wwkkww1983/DC_Electronic_Load/思路一：以实际电流作为y,反馈ADC2作为x，暂时作废/Minisys_new_msp430f5529_beta1.0/Readme.txt

编辑于2020.7.21晚22：46
CC_Mode已经完全OK，还没有增加电流显示函数
实际电流值CC_value_fact还没有设置成全局变量
