wwkkww1983/DC_Electronic_Load/思路一：以实际电流作为y,反馈ADC2作为x，暂时作废/Minisys_new_msp430f5529_beta2.0/Readme.txt

beta2.0编辑于2020.7.22下午15：49
1、CC_Mode已经完全OK，增加了电流显示函数
2、根据季老师的指导，按键KEY3按下瞬间，CC_voltage=CC_value，将用户电流值先直接传送给数转模拟输出DACOUT()，之后再根据ADC2的反馈进行电流值的调整，经过测试大约需要5S左右。
3、界面1还是4个模式CC_mode,CV_Mode,CR_Mode,Developer Mode
4、实际电流值就是实时显示，并没有取平均值，之间测试取平均值会有问题，始终是负数。
5、目前存在的现象是：按下参数调节按键KEY1和KEY2，界面被Hold（保持），只有按下参数确定按键KEY3后监控界面才会有变化，个人判断应该是触动了某些标志变量
