wwkkww1983/DC_Electronic_Load/思路二：以DAC8571实际输出输出DA作为y,实际电流I作为x/Minisys_new_msp430f5529_beta5.0/Readme.txt

1、在Beta4.0恒流模式的基础上增加了恒阻模式CR，到此直流电子负载的基本要求达到满足，发挥部分也完成了2个
编辑于2020/7/28 江瀚林
