wwkkww1983/DC_Electronic_Load/(list of files, cad)

Other CAD files:
思路一：以实际电流作为y,反馈ADC2作为x，暂时作废/Minisys_new_msp430f5529_beta1.0/Debug/src/main.obj
思路一：以实际电流作为y,反馈ADC2作为x，暂时作废/Minisys_new_msp430f5529_beta2.0/Debug/src/main.obj
思路一：以实际电流作为y,反馈ADC2作为x，暂时作废/Minisys_new_msp430f5529_beta3.0/Debug/src/main.obj
思路二：以DAC8571实际输出输出DA作为y,实际电流I作为x/Minisys_new_msp430f5529_beta5.0/Debug/src/main.obj
思路二：以DAC8571实际输出输出DA作为y,实际电流I作为x/Minisys_new_msp430f5529_beta4.0/Debug/src/main.obj
思路一：以实际电流作为y,反馈ADC2作为x，暂时作废/Minisys_new_msp430f5529_beta1.0/Debug/src/device/usci_a0_spi.obj
思路一：以实际电流作为y,反馈ADC2作为x，暂时作废/Minisys_new_msp430f5529_beta1.0/Debug/src/driver/ssd1351.obj
思路一：以实际电流作为y,反馈ADC2作为x，暂时作废/Minisys_new_msp430f5529_beta1.0/Debug/src/system/lut.obj
思路一：以实际电流作为y,反馈ADC2作为x，暂时作废/Minisys_new_msp430f5529_beta1.0/Debug/src/user/display_value.obj
思路一：以实际电流作为y,反馈ADC2作为x，暂时作废/Minisys_new_msp430f5529_beta2.0/Debug/src/device/usci_b0_spi.obj
思路一：以实际电流作为y,反馈ADC2作为x，暂时作废/Minisys_new_msp430f5529_beta2.0/Debug/src/driver/dac8571.obj
思路一：以实际电流作为y,反馈ADC2作为x，暂时作废/Minisys_new_msp430f5529_beta2.0/Debug/src/system/user.obj
思路一：以实际电流作为y,反馈ADC2作为x，暂时作废/Minisys_new_msp430f5529_beta2.0/Debug/src/user/display_value.obj
思路一：以实际电流作为y,反馈ADC2作为x，暂时作废/Minisys_new_msp430f5529_beta3.0/Debug/src/device/soft_spi.obj
思路一：以实际电流作为y,反馈ADC2作为x，暂时作废/Minisys_new_msp430f5529_beta3.0/Debug/src/driver/led.obj
思路一：以实际电流作为y,反馈ADC2作为x，暂时作废/Minisys_new_msp430f5529_beta3.0/Debug/src/system/fonts.obj
思路一：以实际电流作为y,反馈ADC2作为x，暂时作废/Minisys_new_msp430f5529_beta3.0/Debug/src/user/display_value.obj
思路二：以DAC8571实际输出输出DA作为y,实际电流I作为x/Minisys_new_msp430f5529_beta4.0/Debug/src/device/wdt.obj
思路二：以DAC8571实际输出输出DA作为y,实际电流I作为x/Minisys_new_msp430f5529_beta4.0/Debug/src/driver/led.obj
思路二：以DAC8571实际输出输出DA作为y,实际电流I作为x/Minisys_new_msp430f5529_beta4.0/Debug/src/system/user.obj
思路二：以DAC8571实际输出输出DA作为y,实际电流I作为x/Minisys_new_msp430f5529_beta4.0/Debug/src/user/display_value.obj
思路二：以DAC8571实际输出输出DA作为y,实际电流I作为x/Minisys_new_msp430f5529_beta4.0/Debug/src/vector.obj
思路二：以DAC8571实际输出输出DA作为y,实际电流I作为x/Minisys_new_msp430f5529_beta5.0/Debug/src/device/usci_b0_i2c.obj
思路二：以DAC8571实际输出输出DA作为y,实际电流I作为x/Minisys_new_msp430f5529_beta5.0/Debug/src/driver/led.obj
思路二：以DAC8571实际输出输出DA作为y,实际电流I作为x/Minisys_new_msp430f5529_beta5.0/Debug/src/system/user.obj
思路二：以DAC8571实际输出输出DA作为y,实际电流I作为x/Minisys_new_msp430f5529_beta5.0/Debug/src/user/display_value.obj
思路一：以实际电流作为y,反馈ADC2作为x，暂时作废/Minisys_new_msp430f5529_beta1.0/Debug/src/device/usci_b0_spi.obj
思路一：以实际电流作为y,反馈ADC2作为x，暂时作废/Minisys_new_msp430f5529_beta1.0/Debug/src/driver/key.obj
思路一：以实际电流作为y,反馈ADC2作为x，暂时作废/Minisys_new_msp430f5529_beta1.0/Debug/src/system/init.obj
思路一：以实际电流作为y,反馈ADC2作为x，暂时作废/Minisys_new_msp430f5529_beta1.0/Debug/src/vector.obj
思路一：以实际电流作为y,反馈ADC2作为x，暂时作废/Minisys_new_msp430f5529_beta2.0/Debug/src/device/usci_a0_spi.obj
思路一：以实际电流作为y,反馈ADC2作为x，暂时作废/Minisys_new_msp430f5529_beta2.0/Debug/src/driver/ads1118.obj
思路一：以实际电流作为y,反馈ADC2作为x，暂时作废/Minisys_new_msp430f5529_beta2.0/Debug/src/system/lut.obj
思路一：以实际电流作为y,反馈ADC2作为x，暂时作废/Minisys_new_msp430f5529_beta2.0/Debug/src/vector.obj
思路一：以实际电流作为y,反馈ADC2作为x，暂时作废/Minisys_new_msp430f5529_beta3.0/Debug/src/device/usci_b0_i2c.obj
思路一：以实际电流作为y,反馈ADC2作为x，暂时作废/Minisys_new_msp430f5529_beta3.0/Debug/src/driver/key.obj
思路一：以实际电流作为y,反馈ADC2作为x，暂时作废/Minisys_new_msp430f5529_beta3.0/Debug/src/system/user.obj
思路一：以实际电流作为y,反馈ADC2作为x，暂时作废/Minisys_new_msp430f5529_beta3.0/Debug/src/vector.obj
思路二：以DAC8571实际输出输出DA作为y,实际电流I作为x/Minisys_new_msp430f5529_beta4.0/Debug/src/device/ucs.obj
思路二：以DAC8571实际输出输出DA作为y,实际电流I作为x/Minisys_new_msp430f5529_beta4.0/Debug/src/driver/key.obj
思路二：以DAC8571实际输出输出DA作为y,实际电流I作为x/Minisys_new_msp430f5529_beta4.0/Debug/src/system/init.obj
思路二：以DAC8571实际输出输出DA作为y,实际电流I作为x/Minisys_new_msp430f5529_beta5.0/Debug/src/device/usci_b1_spi.obj
思路二：以DAC8571实际输出输出DA作为y,实际电流I作为x/Minisys_new_msp430f5529_beta5.0/Debug/src/driver/ssd1351.obj
思路二：以DAC8571实际输出输出DA作为y,实际电流I作为x/Minisys_new_msp430f5529_beta5.0/Debug/src/system/lut.obj
思路二：以DAC8571实际输出输出DA作为y,实际电流I作为x/Minisys_new_msp430f5529_beta5.0/Debug/src/vector.obj
思路一：以实际电流作为y,反馈ADC2作为x，暂时作废/Minisys_new_msp430f5529_beta1.0/Debug/src/device/usci_a1_spi.obj
思路一：以实际电流作为y,反馈ADC2作为x，暂时作废/Minisys_new_msp430f5529_beta1.0/Debug/src/driver/dac8571.obj
思路一：以实际电流作为y,反馈ADC2作为x，暂时作废/Minisys_new_msp430f5529_beta1.0/Debug/src/system/fonts.obj
思路一：以实际电流作为y,反馈ADC2作为x，暂时作废/Minisys_new_msp430f5529_beta2.0/Debug/src/device/soft_i2c.obj
思路一：以实际电流作为y,反馈ADC2作为x，暂时作废/Minisys_new_msp430f5529_beta2.0/Debug/src/driver/key.obj
思路一：以实际电流作为y,反馈ADC2作为x，暂时作废/Minisys_new_msp430f5529_beta2.0/Debug/src/system/fonts.obj
思路一：以实际电流作为y,反馈ADC2作为x，暂时作废/Minisys_new_msp430f5529_beta3.0/Debug/src/device/usci_b0_spi.obj
思路一：以实际电流作为y,反馈ADC2作为x，暂时作废/Minisys_new_msp430f5529_beta3.0/Debug/src/driver/dac8571.obj
思路一：以实际电流作为y,反馈ADC2作为x，暂时作废/Minisys_new_msp430f5529_beta3.0/Debug/src/system/init.obj
思路二：以DAC8571实际输出输出DA作为y,实际电流I作为x/Minisys_new_msp430f5529_beta4.0/Debug/src/device/soft_i2c.obj
思路二：以DAC8571实际输出输出DA作为y,实际电流I作为x/Minisys_new_msp430f5529_beta4.0/Debug/src/driver/ssd1351.obj
思路二：以DAC8571实际输出输出DA作为y,实际电流I作为x/Minisys_new_msp430f5529_beta4.0/Debug/src/system/lut.obj
思路二：以DAC8571实际输出输出DA作为y,实际电流I作为x/Minisys_new_msp430f5529_beta5.0/Debug/src/device/usci_b1_i2c.obj
思路二：以DAC8571实际输出输出DA作为y,实际电流I作为x/Minisys_new_msp430f5529_beta5.0/Debug/src/driver/ads1118.obj
思路二：以DAC8571实际输出输出DA作为y,实际电流I作为x/Minisys_new_msp430f5529_beta5.0/Debug/src/system/init.obj
思路一：以实际电流作为y,反馈ADC2作为x，暂时作废/Minisys_new_msp430f5529_beta1.0/Debug/src/device/usci_b0_i2c.obj
思路一：以实际电流作为y,反馈ADC2作为x，暂时作废/Minisys_new_msp430f5529_beta1.0/Debug/src/driver/ads1118.obj
思路一：以实际电流作为y,反馈ADC2作为x，暂时作废/Minisys_new_msp430f5529_beta1.0/Debug/src/system/user.obj
思路一：以实际电流作为y,反馈ADC2作为x，暂时作废/Minisys_new_msp430f5529_beta2.0/Debug/src/device/usci_a1_spi.obj
思路一：以实际电流作为y,反馈ADC2作为x，暂时作废/Minisys_new_msp430f5529_beta2.0/Debug/src/driver/led.obj
思路一：以实际电流作为y,反馈ADC2作为x，暂时作废/Minisys_new_msp430f5529_beta2.0/Debug/src/system/init.obj
思路一：以实际电流作为y,反馈ADC2作为x，暂时作废/Minisys_new_msp430f5529_beta3.0/Debug/src/device/ucs.obj
思路一：以实际电流作为y,反馈ADC2作为x，暂时作废/Minisys_new_msp430f5529_beta3.0/Debug/src/driver/ads1118.obj
思路一：以实际电流作为y,反馈ADC2作为x，暂时作废/Minisys_new_msp430f5529_beta3.0/Debug/src/system/lut.obj
思路二：以DAC8571实际输出输出DA作为y,实际电流I作为x/Minisys_new_msp430f5529_beta4.0/Debug/src/device/usci_b0_spi.obj
思路二：以DAC8571实际输出输出DA作为y,实际电流I作为x/Minisys_new_msp430f5529_beta4.0/Debug/src/driver/ads1118.obj
思路二：以DAC8571实际输出输出DA作为y,实际电流I作为x/Minisys_new_msp430f5529_beta4.0/Debug/src/system/fonts.obj
思路二：以DAC8571实际输出输出DA作为y,实际电流I作为x/Minisys_new_msp430f5529_beta5.0/Debug/src/device/usci_a1_spi.obj
思路二：以DAC8571实际输出输出DA作为y,实际电流I作为x/Minisys_new_msp430f5529_beta5.0/Debug/src/driver/dac8571.obj
思路二：以DAC8571实际输出输出DA作为y,实际电流I作为x/Minisys_new_msp430f5529_beta5.0/Debug/src/system/fonts.obj
思路一：以实际电流作为y,反馈ADC2作为x，暂时作废/Minisys_new_msp430f5529_beta1.0/Debug/src/device/ucs.obj
思路一：以实际电流作为y,反馈ADC2作为x，暂时作废/Minisys_new_msp430f5529_beta1.0/Debug/src/driver/led.obj
思路一：以实际电流作为y,反馈ADC2作为x，暂时作废/Minisys_new_msp430f5529_beta2.0/Debug/src/device/usci_b0_i2c.obj
思路一：以实际电流作为y,反馈ADC2作为x，暂时作废/Minisys_new_msp430f5529_beta2.0/Debug/src/driver/ssd1351.obj
思路一：以实际电流作为y,反馈ADC2作为x，暂时作废/Minisys_new_msp430f5529_beta3.0/Debug/src/device/usci_a0_spi.obj
思路一：以实际电流作为y,反馈ADC2作为x，暂时作废/Minisys_new_msp430f5529_beta3.0/Debug/src/driver/ssd1351.obj
思路二：以DAC8571实际输出输出DA作为y,实际电流I作为x/Minisys_new_msp430f5529_beta4.0/Debug/src/device/usci_b1_spi.obj
思路二：以DAC8571实际输出输出DA作为y,实际电流I作为x/Minisys_new_msp430f5529_beta4.0/Debug/src/driver/dac8571.obj
思路二：以DAC8571实际输出输出DA作为y,实际电流I作为x/Minisys_new_msp430f5529_beta5.0/Debug/src/device/ucs.obj
思路二：以DAC8571实际输出输出DA作为y,实际电流I作为x/Minisys_new_msp430f5529_beta5.0/Debug/src/driver/key.obj
思路一：以实际电流作为y,反馈ADC2作为x，暂时作废/Minisys_new_msp430f5529_beta1.0/Debug/src/device/soft_i2c.obj
思路一：以实际电流作为y,反馈ADC2作为x，暂时作废/Minisys_new_msp430f5529_beta2.0/Debug/src/device/usci_b1_i2c.obj
思路一：以实际电流作为y,反馈ADC2作为x，暂时作废/Minisys_new_msp430f5529_beta3.0/Debug/src/device/wdt.obj
思路二：以DAC8571实际输出输出DA作为y,实际电流I作为x/Minisys_new_msp430f5529_beta4.0/Debug/src/device/usci_a1_spi.obj
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
