wwkkww1983/DC_Electronic_Load/思路一：以实际电流作为y,反馈ADC2作为x，暂时作废/Minisys_new_msp430f5529_beta1.0/src/driver/ads1118.c

/*

 * ads1118.c
 *
 *  Created on: 2018-05-17 11:23
 *      Author: Jack Chen <redchenjs@live.com>
 *  Fixed on :  2018-05-25 11:14
 *      Author: art-j <jjw903427521@gmail.com>
*/

/*

#include <stdint.h>
#include <string.h>

#include <msp430.h>

#include <inc/driver/ads1118.h>
#include <inc/device/usci_b1_spi.h>

#define SS_NONE     0b0
#define SS_START    0b1

#define MUX_D0_1    0b000
#define MUX_D0_3    0b001
#define MUX_D1_3    0b010
#define MUX_D2_3    0b011
#define MUX_S0      0b100
#define MUX_S1      0b101
#define MUX_S2      0b110
#define MUX_S3      0b111

#define PGA_6_144   0b000
#define PGA_4_096   0b001
#define PGA_2_048   0b010
#define PGA_1_024   0b011
#define PGA_0_512   0b100
#define PGA_0_256   0b101

#define MODE_CONTINOUS  0b0
#define MODE_SINGLE     0b1

#define DR_8_SPS    0b000
#define DR_16_SPS   0b001
#define DR_32_SPS   0b010
#define DR_64_SPS   0b011
#define DR_128_SPS  0b100
#define DR_250_SPS  0b101
#define DR_475_SPS  0b110
#define DR_860_SPS  0b111

#define TS_MODE_ADC     0b0
#define TS_MODE_TEMP    0b1

#define PULL_UP_EN_OFF  0b0
#define PULL_UP_EN_ON   0b1

#define NOP_DATA_INVALID    0b00
#define NOP_DATA_VALID      0b01

#define RESERVED_BIT    0b1

static ads1118_t ads1118_dev;
ads1118_t *ads1118 = &ads1118_dev;

static int16_t ads1118_transmit(uint8_t *data)
{
    unsigned char tx_buff[4] = {0};
    unsigned char rx_buff[4] = {0};

    tx_buff[0] = data[1];
    tx_buff[1] = data[0];
    tx_buff[2] = 0;
    tx_buff[3] = 0;

    P4OUT &=~BIT0;
    usci_b1_spi_transmit_frame(tx_buff, rx_buff, 4);
    P4OUT |= BIT0;

    return rx_buff[0] << 8 | rx_buff[1];
}

void ads1118_set_channel(uint8_t channel)
{
    switch (channel) {
    case 0:
        ads1118->bits.mux = MUX_S0;
        break;
    case 1:
        ads1118->bits.mux = MUX_S1;
        break;
    case 2:
        ads1118->bits.mux = MUX_S2;
        break;
    case 3:
        ads1118->bits.mux = MUX_S3;
        break;
    default:
        return;
    }

    ads1118_transmit((uint8_t *)ads1118);
}

int16_t ads1118_convert(void)
{
    return ads1118_transmit((uint8_t *)"\x00\x00");
}

void ads1118_init(void)
{
    P4DIR |= BIT0;
    P4OUT |= BIT0;

    memset(&ads1118_dev, 0, sizeof(ads1118_dev));

    ads1118->bits.ss = SS_NONE;
    ads1118->bits.mux = MUX_S0;
    ads1118->bits.pga = PGA_2_048;
    ads1118->bits.mode = MODE_CONTINOUS;
    ads1118->bits.dr = DR_860_SPS;
    ads1118->bits.ts_mode = TS_MODE_ADC;
    ads1118->bits.pull_up_en = PULL_UP_EN_ON;
    ads1118->bits.nop = NOP_DATA_VALID;
    ads1118->bits.reserved = RESERVED_BIT;

    ads1118_transmit((uint8_t *)ads1118);
}
*/

//////////////////////////////////////////////////////
//AIN输入端口（正-负）                              //
//  0:AIN0-AIN1 1:AIN0-AIN3 2:AIN1-AIN3 3:AIN2-AIN3 //
//  4:AIN0-GND  5:AIN1-GND  6:AIN2-GND  7:AIN3-GND  //
//量程                                                //
//  0:±6.144V 1:±4.096V 2:±2.048V 3:±1.024V     //
//  4:±0.512V 5:±0.256V 6:±0.256V 7:±0.256V     //
//////////////////////////////////////////////////////
#include "msp430f5529.h"
#include <inc/driver/ssd1351.h>
#include <inc/system/fonts.h>
#include <stdio.h>
#include <math.h>
#include <src/user/display_value.h>
#include <inc/system/user.h>
#define SCLK_H P4OUT |= BIT3
#define SCLK_L P4OUT &= ~BIT3
#define CS_H P4OUT |= BIT0
#define CS_L P4OUT &= ~BIT0
#define DataIN_H P4OUT |= BIT1
#define DataIN_L P4OUT &= ~BIT1

#define uint unsigned int
#define uchar unsigned char
float a0 = 0, a1 = 0, a2 = 0;

void ADS1118_Init(void)
{
    P4DIR |= BIT0;  //CS
    P4DIR |= BIT3;  //SCK
    P4DIR |= BIT1;  //输出，单片机写数据DIN
    P4DIR &= ~BIT2; //输入，单片机读数据OUT
}

//****************************************************************
//* 函数名称：WriteSPI
//* 功能描述：开始SPI写数据
//* 入口参数：config
//* 返回参数：void
//****************************************************************
void WriteSPI(uint config)
{
    uint i = 0;
    CS_L;
    SCLK_L;
    //delay_us(200);
    for (i = 0; i < 16; i++)
    {
        SCLK_H;
        //delay_us(200);
        if (config & 0x8000)
        {
            DataIN_H;
        }
        else
        {
            DataIN_L;
        }
        config <<= 1;
        SCLK_L;
        //delay_us(200);
    }
    CS_H;
}

//****************************************************************
//* 函数名称：ADS_ReadSPI读
//* 功能描述：开始SPI读数据
//* 入口参数：void
//* 返回参数：unsigned int
//****************************************************************
uint ADS_Read()
{
    uint i = 0;
    uint adc;
    CS_L;
    adc = 0x0000;

    while (P4IN & BIT2)
        ; //进行一次转换起始判断
    DataIN_H;
    SCLK_L;
    for (i = 0; i < 16; i++) //读取数据，单个位读取，共16位、高位开始
    {
        adc = adc << 1;
        SCLK_H;
        //delay_us(200);
        if (P4IN & BIT2)
        {
            adc |= 0x0001;
        }
        else
        {
            adc &= ~0x0001;
        }
        SCLK_L;

        //delay_us(200);
    }
    CS_H;
    return adc;
}

//****************************************************************
//* 函数名称：ADS1118_Config
//* 功能描述：配置寄存器
//* 入口参数：add---ADS1118的寄存器配置
//* 返回参数：void
//****************************************************************
void ADS1118_Config(uchar port, uchar scale)
{
    WriteSPI(0x81e3 + port * 4096 + scale * 512); //C1E3  1100 0001 1110 0011
}
//****************************************************************
//* 函数名称：ADS1118
//* 功能描述：进行一次AD转换
//* 入口参数：port---AIN输入端口(0~7)  scale---满量程(0~7)
//* 返回参数：void
//****************************************************************
float ADS1118(uchar port, uchar scale)
{
    float value;
    ADS1118_Config(port, scale);
    value = ADS_Read();
    if (value > 0x7FFF)
        value -= 0x10000;
    switch (scale)
    {
    case 0:
        value *= 6.144;
        break;
    case 1:
        value *= 4.096;
        break;
    case 2:
        value *= 2.048;
        break;
    case 3:
        value *= 1.024;
        break;
    case 4:
        value *= 0.512;
        break;
    case 5:
        value *= 0.256;
        break;
    case 6:
        value *= 0.256;
        break;
    case 7:
        value *= 0.256;
        break;
    default:
        break;
    }
    value /= 32768.0;
    return value;
}

float average_voltage_caculate(unsigned char channel, unsigned char times) //传入参数为通道号和采样次数
{
    char i = 0;
    float sum = 0, AD = 0, max = 0, min = 10;
    for (i = times; i > 0; i--)
    {
        AD = ADS1118(channel, 1);
        if (max < AD)
        {
            max = AD;
        }
        if (min > AD)
        {
            min = AD;
        }
        sum = sum + AD;
    }
    sum = (sum - max - min) / (times - 2); //减2是因为max和min
    return sum;
}

void cc_mode_adc2_feedback(float v)
{
    float CC_value_fact = 0, temp = 0;
    if (v <= 0.825)
        CC_value_fact = 0.0205 * pow(v, 2) + 0.8528 * v - 0.0066;
    else if (v <= 1.65)
        CC_value_fact = -0.01 * pow(v, 2) + 0.8805 * v - 0.0125;
    else if (v <= 2.475)
        CC_value_fact = -0.009 * pow(v, 2) + 0.8759 * v - 0.0087;
    else
        CC_value_fact = 0.004 * pow(v, 2) + 0.7899 * v + 0.1241;

    //差值判断程序块
    temp = CC_value_fact - CC_value;
    if (temp >= 1) //差值temp>=1  减量  1
    {
        CC_voltage -= 1;
    }
    else if (temp >= 0.5) //差值0.5<=temp<1   减量    0.2
    {
        CC_voltage -= 0.2;
    }
    else if (temp >=0.1) //差值0.1<=temp<0.5  减量    0.15
    {
        CC_voltage -= 0.15;
    }
    else if (temp >= 0.02) //差值0.02<=temp<0.1   减量  0.002
    {
        CC_voltage -= 0.002;
    }
    else if (temp >= 0) //差值0<=temp<0.02    减量0.001
    {
        CC_voltage -= 0.001;
    }
    else if (temp >= -0.02) //差值-0.02<=temp<0   增量=0.001
    {
        CC_voltage += 0.001;
    }
    else if (temp >= -0.1) //差值-0.1<=temp<-0.02  增量=0.002
    {
        CC_voltage += 0.002;
    }
    else if (temp >= -0.5) //差值-0.5<=temp<-0.1  增量=0.15
    {
        CC_voltage += 0.15;
    }
    else if (temp >= -1) //差值-1<=temp<-0.5   增量=0.2
    {
        CC_voltage += 0.2;
    }
    else //差值temp<-2A   增量=1
        CC_voltage += 1;
}

void get_ads1118_sample_voltage(void)
{
    char v0[12] = {}; //字符数组，用来保存电压值
    a0 = average_voltage_caculate(4, 10); //选择模拟输入通道0，将采样的电压上限设置为±4.096V
    sprintf(v0, "A0= %.3fV ", a0);        //将A0的电压转换成字符串保存在数组中
    ssd1351_display_string(0, 52, v0, 0, Lime, Black);
    switch (jiantou)
    {
    case 1:
        a2 = average_voltage_caculate(6, 10);
        sprintf(v0, "%.3fV ", a2); //A2通道的电压
        ssd1351_display_string(41, 80, v0, 1, White, Black);
        break;
    case 2:
        a1 = average_voltage_caculate(5, 10);
        sprintf(v0, "%.3fV ", a1); //A1通道的电压
        ssd1351_display_string(41, 80, v0, 1, White, Black);
        break;
    default:
        break;
    }

    /*
     *  方法一：通过定义单独的字符数组进行显示
     *  char v0[20],v1[20];
        float voltage[4];
        voltage[0] =ADS1118 (4, 1);
        voltage[1] =ADS1118 (5, 1);

        sprintf(v0,"Ch0= %.3fV",voltage[0]);
        sprintf(v1,"Ch1= %.3fV",voltage[1]);

        ssd1351_display_string(0,0,v0,1,White,Black);
        ssd1351_display_string(0,20,v1,1,White,Black);*/

    /*
     *  方法二：通过定义二维数组进行显示
        char v0[4][15]={0};
        float voltage[4];
        voltage[0] =ADS1118 (4, 1);
        voltage[1] =ADS1118 (5, 1);

        sprintf(v0[0],"Ch0= %.3fV",voltage[0]);
        sprintf(v0[1],"Ch1= %.3fV",voltage[1]);

        ssd1351_display_string(0,0,v0[0],1,White,Black);
        ssd1351_display_string(0,20,v0[1],1,White,Black);
    */
}
