wwkkww1983/DC_Electronic_Load/思路一：以实际电流作为y,反馈ADC2作为x，暂时作废/Minisys_new_msp430f5529_beta1.0/src/system/lut.c

/*
 * lut.c
 *
 *  Created on: 2018-05-20 09:51
 *      Author: Jack Chen <redchenjs@live.com>
 */

const double dac0_vi_table[801] = {
    0.3627, 0.3645, 0.3663, 0.3681, 0.3701, 0.3719, 0.3737, 0.3755,
    0.3773, 0.3791, 0.3807, 0.3826, 0.3845, 0.3864, 0.3882, 0.3902,
    0.3919, 0.3938, 0.3955, 0.3974, 0.3991, 0.4010, 0.4028, 0.4046,
    0.4065, 0.4083, 0.4102, 0.4120, 0.4138, 0.4157, 0.4175, 0.4194,
    0.4212, 0.4232, 0.4250, 0.4267, 0.4284, 0.4304, 0.4322, 0.4340,
    0.4357, 0.4376, 0.4393, 0.4412, 0.4431, 0.4449, 0.4467, 0.4485,
    0.4502, 0.4521, 0.4539, 0.4557, 0.4574, 0.4593, 0.4611, 0.4630,
    0.4648, 0.4666, 0.4683, 0.4702, 0.4720, 0.4738, 0.4756, 0.4775,
    0.4793, 0.4811, 0.4828, 0.4847, 0.4865, 0.4883, 0.4901, 0.4920,
    0.4938, 0.4956, 0.4975, 0.4993, 0.5010, 0.5030, 0.5049, 0.5067,
    0.5084, 0.5102, 0.5120, 0.5139, 0.5157, 0.5175, 0.5194, 0.5212,
    0.5231, 0.5248, 0.5266, 0.5284, 0.5302, 0.5321, 0.5339, 0.5356,
    0.5374, 0.5392, 0.5410, 0.5421, 0.5448, 0.5466, 0.5484, 0.5500,
    0.5519, 0.5537, 0.5555, 0.5573, 0.5591, 0.5609, 0.5627, 0.5646,
    0.5665, 0.5683, 0.5701, 0.5719, 0.5737, 0.5755, 0.5774, 0.5792,
    0.5810, 0.5829, 0.5847, 0.5865, 0.5884, 0.5902, 0.5919, 0.5938,
    0.5956, 0.5974, 0.5992, 0.6011, 0.6028, 0.6047, 0.6066, 0.6083,
    0.6101, 0.6119, 0.6136, 0.6154, 0.6172, 0.6190, 0.6208, 0.6226,
    0.6244, 0.6262, 0.6281, 0.6299, 0.6318, 0.6336, 0.6354, 0.6371,
    0.6388, 0.6407, 0.6425, 0.6442, 0.6462, 0.6480, 0.6500, 0.6517,
    0.6536, 0.6554, 0.6574, 0.6592, 0.6611, 0.6630, 0.6647, 0.6665,
    0.6683, 0.6701, 0.6719, 0.6738, 0.6756, 0.6775, 0.6792, 0.6809,
    0.6829, 0.6846, 0.6864, 0.6884, 0.6900, 0.6919, 0.6936, 0.6955,
    0.6974, 0.6992, 0.7010, 0.7028, 0.7047, 0.7065, 0.7083, 0.7101,
    0.7118, 0.7137, 0.7155, 0.7172, 0.7189, 0.7207, 0.7225, 0.7242,
    0.7261, 0.7279, 0.7297, 0.7315, 0.7333, 0.7351, 0.7368, 0.7386,
    0.7405, 0.7423, 0.7441, 0.7460, 0.7478, 0.7497, 0.7515, 0.7533,
    0.7552, 0.7568, 0.7586, 0.7605, 0.7623, 0.7642, 0.7660, 0.7678,
    0.7698, 0.7715, 0.7732, 0.7752, 0.7770, 0.7788, 0.7806, 0.7824,
    0.7842, 0.7860, 0.7877, 0.7895, 0.7914, 0.7932, 0.7951, 0.7969,
    0.7986, 0.8004, 0.8021, 0.8039, 0.8057, 0.8075, 0.8093, 0.8110,
    0.8128, 0.8147, 0.8164, 0.8184, 0.8202, 0.8221, 0.8239, 0.8257,
    0.8275, 0.8293, 0.8312, 0.8331, 0.8348, 0.8365, 0.8384, 0.8402,
    0.8420, 0.8439, 0.8457, 0.8475, 0.8492, 0.8510, 0.8529, 0.8547,
    0.8565, 0.8583, 0.8601, 0.8618, 0.8636, 0.8655, 0.8673, 0.8690,
    0.8708, 0.8725, 0.8744, 0.8763, 0.8780, 0.8797, 0.8814, 0.8833,
    0.8851, 0.8869, 0.8888, 0.8907, 0.8925, 0.8943, 0.8961, 0.8979,
    0.8999, 0.9018, 0.9037, 0.9056, 0.9075, 0.9094, 0.9113, 0.9131,
    0.9149, 0.9167, 0.9182, 0.9201, 0.9219, 0.9237, 0.9254, 0.9271,
    0.9291, 0.9308, 0.9324, 0.9342, 0.9360, 0.9377, 0.9394, 0.9412,
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
};
