wwkkww1983/DC_Electronic_Load/思路一：以实际电流作为y,反馈ADC2作为x，暂时作废/Minisys_new_msp430f5529_beta1.0/src/device/ucs.c

/*
 * ucs.c
 *
 *  Created on: 2018-05-18 11:26
 *      Author: Jack Chen <redchenjs@live.com>
 * 
 *  clock out：
 *      ACLK:  P1.0
 *      SMCLK: P2.2
 *      MCLK:  P7.7
 */

#include <msp430f5529.h>

#define SET_ACLK_OUT	P1SEL |= BIT0; P1DIR |= BIT0	// 设置P1.0为ACLK输出
#define SET_SMCLK_OUT	P2SEL |= BIT2; P2DIR |= BIT2	// 设置P2.2为SMCLK输出
#define SET_MCLK_OUT	P7SEL |= BIT7; P7DIR |= BIT7	// 设置P7.7为MCLK输出

static void set_vcore_up(unsigned int level)
{
    // Open PMM registers for write
    PMMCTL0_H = PMMPW_H;
    // Set SVS/SVM high side new level
    SVSMHCTL = SVSHE + SVSHRVL0 * level + SVMHE + SVSMHRRL0 * level;
    // Set SVM low side to new level
    SVSMLCTL = SVSLE + SVMLE + SVSMLRRL0 * level;
    // Wait till SVM is settled
    while ((PMMIFG & SVSMLDLYIFG) == 0);
    // Clear already set flags
    PMMIFG &= ~(SVMLVLRIFG + SVMLIFG);
    // Set VCore to new level
    PMMCTL0_L = PMMCOREV0 * level;
    // Wait till new level reached
    if ((PMMIFG & SVMLIFG)) {
        while ((PMMIFG & SVMLVLRIFG) == 0);
    }
    // Set SVS/SVM low side to new level
    SVSMLCTL = SVSLE + SVSLRVL0 * level + SVMLE + SVSMLRRL0 * level;
    // Lock PMM registers for write access
    PMMCTL0_H = 0x00;
}

void ucs_init(void)
{
  // SET_MCLK_OUT;     // 开启MCLK输出
  // SET_ACLK_OUT;     // 开启ACLK输出
  // SET_SMCLK_OUT;    // 开启SMCLK输出

//     Increase Vcore setting to level3 to support fsystem=25MHz
//     NOTE: Change core voltage one level at a time..
    set_vcore_up(0x01);
    set_vcore_up(0x02);
    set_vcore_up(0x03);

    UCSCTL3 = SELREF_2;                       // Set DCO FLL reference = REFO
    UCSCTL4 |= SELA_2;                        // Set ACLK = REFO

    __bis_SR_register(SCG0);                  // Disable the FLL control loop
    UCSCTL0 = 0x0000;                         // Set lowest possible DCOx, MODx
    UCSCTL1 = DCORSEL_7;                      // Select DCO range 50MHz operation
    UCSCTL2 = FLLD_0 + 762;                   // Set DCO Multiplier for 25MHz
                                              // (N + 1) * FLLRef = Fdco
                                              // (762 + 1) * 32768 = 25MHz
                                              // Set FLL Div = fDCOCLK/2
    __bic_SR_register(SCG0);                  // Enable the FLL control loop

    // Worst-case settling time for the DCO when the DCO range bits have been
    // changed is n x 32 x 32 x f_MCLK / f_FLL_reference. See UCS chapter in 5xx
    // UG for optimization.
    // 32 x 32 x 25 MHz / 32,768 Hz ~ 780k MCLK cycles for DCO to settle
    __delay_cycles(782000);

    // Loop until XT1,XT2 & DCO stabilizes - In this case only DCO has to stabilize
    do {
      UCSCTL7 &= ~(XT2OFFG + XT1LFOFFG + DCOFFG);
                                              // Clear XT2,XT1,DCO fault flags
      SFRIFG1 &= ~OFIFG;                      // Clear fault flags
    } while (SFRIFG1&OFIFG);                  // Test oscillator fault flag

}
