wwkkww1983/DC_Electronic_Load/思路一：以实际电流作为y,反馈ADC2作为x，暂时作废/Minisys_new_msp430f5529_beta1.0/src/driver/led.c

/*
 * led.c
 *
 *  Created on: 2018-02-13 15:53
 *      Author: Jack Chen <redchenjs@live.com>
 *  Fixed on :  2018-05-25 11:14
 *      Author: art-j <jjw903427521@gmail.com>
 */


#include <msp430.h>

void led_on(void)
{
    char i;
    P1OUT |= BIT0;
    for(i=250;i>0;i--)
    {
    __delay_cycles(60000);
    __delay_cycles(60000);
    __delay_cycles(60000);
    __delay_cycles(60000);
    }
}

void led_off(void)
{
    P1OUT &=~BIT0;
}

void led_init(void)
{
    P1DIR |= BIT0;
    led_on();
    led_off();
}
