wwkkww1983/DC_Electronic_Load/思路一：以实际电流作为y,反馈ADC2作为x，暂时作废/Minisys_new_msp430f5529_beta3.0/src/user/display_value.h

/*
 * display_value.h
 *
 *  Created on: 2020年7月17日
 *      Author: jianghanlin
 */

#ifndef SRC_USER_DISPLAY_VALUE_H_
#define SRC_USER_DISPLAY_VALUE_H_


extern void display_value();
extern float CC_value,CV_value,CR_value,CC_voltage;
extern unsigned char back,chuan_dianliu_flag;
#endif /* SRC_USER_DISPLAY_VALUE_H_ */
