wwkkww1983/DC_Electronic_Load/(commit log)

2020-08-24 Rev1.0
    第一次加入工程文件
    [HT1621.obj, HX711.OBJ, I2C.obj, LCD1602.OBJ, LCD_128.obj, PCB1.PcbDoc, Sheet1.SchDoc, TCA6416A.obj]
2020-08-24 Rev1.1
    删除了Altium的备份文件
2020-08-24 Rev1.1
    项目站点构建成功
2020-10-23 Rev 1.2
    1、找回损坏文件
    [HT1621.obj, HX711.OBJ, I2C.obj, LCD1602.OBJ, LCD_128.obj, PCB1.PcbDoc, Sheet1.SchDoc, TCA6416A.obj]
